Legionofloss/TempSensCoolingTent/Temperature Sensor.kicad_sch

## KiCad design Temperature Sensor.kicad_sch (2026-10-25)

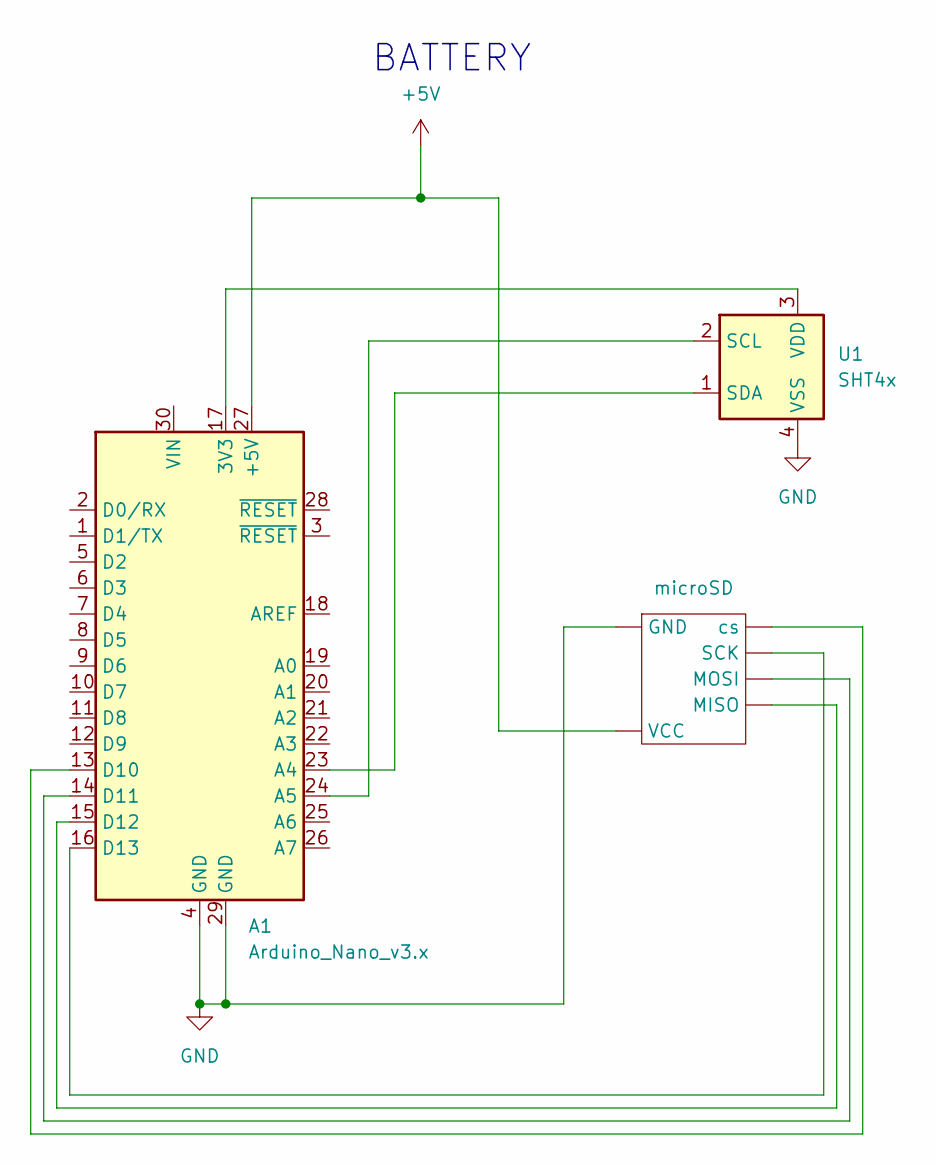
[picture p13: schematic Temperature Sensor.kicad_sch]

Parts:
A1: Arduino_Nano_v3.x; Arduino_Nano
U1: SHT4x; Sensirion_DFN-4_1.5x1.5mm_P0.8mm_SHT4x_NoCentralPad
microSD: (no value)

Connections:
+5V: A1.27 (+5V), microSD.
GND: A1.4 (GND), A1.29 (GND), U1.4 (VSS), microSD.
unnamed: A1.13 (D10), microSD.
unnamed: A1.14 (D11), microSD.
unnamed: A1.15 (D12), microSD.
unnamed: A1.16 (D13), microSD.
unnamed: A1.17 (3V3), U1.3 (VDD)
unnamed: A1.23 (A4), U1.1 (SDA)
unnamed: A1.24 (A5), U1.2 (SCL)

Notes on the sheet:
BATTERY
