Legionofloss/TempSensCoolingTent/(commit log)

2026-03-18 Initial Commit - populating repo
    First Published Code - Needs to be modified for new sensor
2026-03-22 Create SHT41_Code
    Transitioning to SHT41 temp and humidity sensor
2026-03-24 Update SHT41_Code.ino
    Adding Blinking for error detection on board
    [SHT41_Code.ino]
2026-09-30 TempSensor Schematic
2026-10-25 Fix typo in Arduino spelling in README
2026-10-25 Upload Temp Sensor Schematic
    [Temperature Sensor.kicad_sch]
2026-10-25 Upload Some Images
    Add sensor images and graphed examples
2026-10-25 Move previous config
    DHT sensor no longer used, so put into legacy folder
    [Sensorode.ino]
2026-10-25 Upload Data
    Including raw sensor and modified data in excel format.
    [3_26_26_START_7_55_ENDAROUND2_WITHGRAPHS.xlsx, 3_30_26_7_35_START_NOFANS_WITHGRAPHS.xlsx, 4_17_Outside.CSV, Inside Log 3_26_26 From 7_55to around 2pm.csv, InsideLog_3_30_26_7_35_START_NOFANS.csv, InsideLog_3_30_26_7_35_START_NOFANS.xlsx, LOG_INSIDE_4_17.CSV, ModifiedW_Graph_4_17.xlsx]
